timembedded/Carnivore2/Board/3d/CUI_DEVICES_SJ1-3525N.step

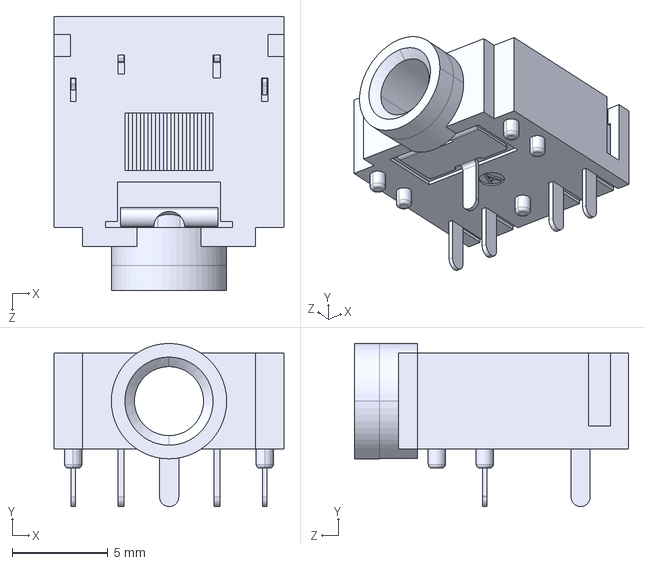
[picture p1: CAD file, 2024-03-19]
Board/3d/CUI_DEVICES_SJ1-3525N.step
12.0 x 8.51 x 14.3 mm
