timembedded/Carnivore2/Board/3d/SG3225CAN.stp

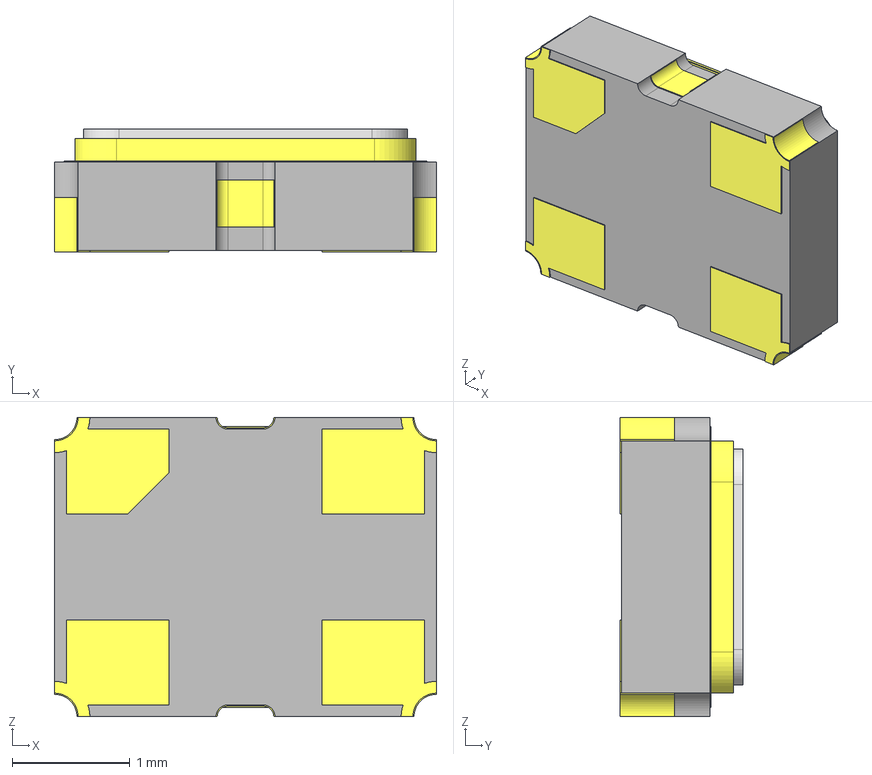
[picture p2: CAD file, 2024-03-19]
Board/3d/SG3225CAN.stp
3.24 x 1.04 x 2.54 mm
SG3225CAN0001
SG3225CAN0002
SG3225CAN0003
SG3225CAN0004
SG3225CAN0005
SG3225CAN0006
SG3225CAN0007
