timembedded/Carnivore2/Board/3d/3505-34-01_step.stp

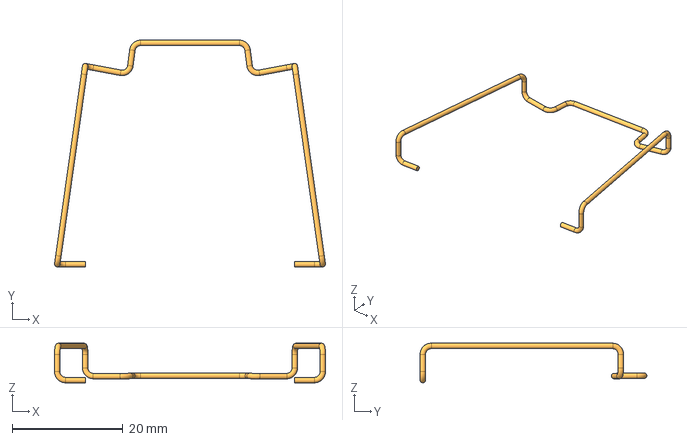
[picture p3: CAD file, 2024-03-19]
Board/3d/3505-34-01_step.stp
49.0 x 41.0 x 7.16 mm
