timembedded/Carnivore2/Board/3d/header_awhw10g-0202-t.stp

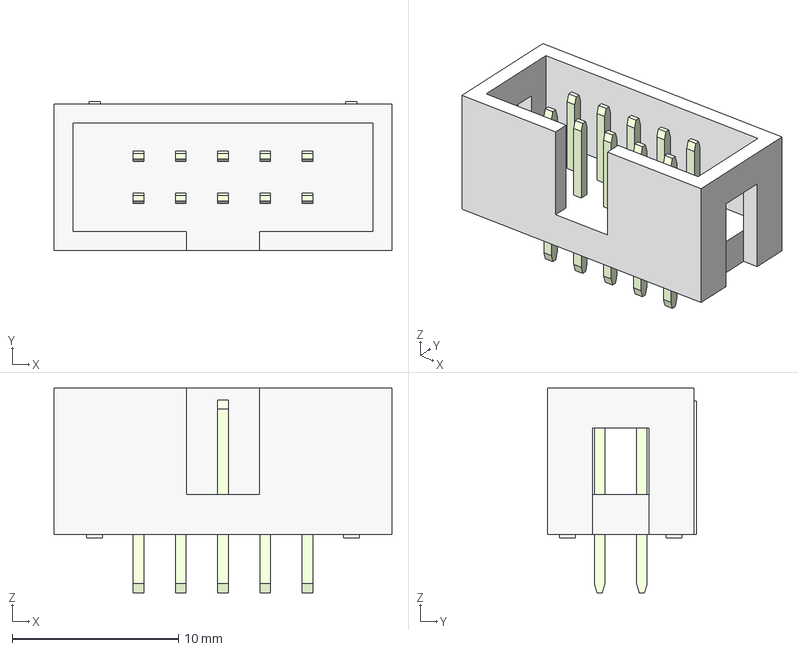
[picture p4: CAD file, 2024-03-19]
Board/3d/header_awhw10g-0202-t.stp
20.3 x 8.95 x 12.3 mm
