timembedded/Carnivore2/Board/3d/N7E50-X516-20-01_step.stp

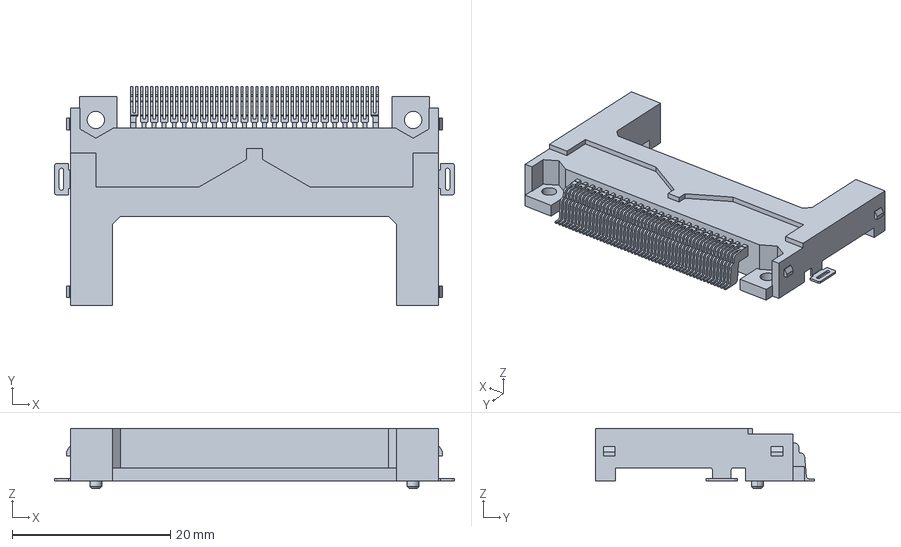
[picture p5: CAD file, 2024-03-19]
Board/3d/N7E50-X516-20-01_step.stp
50.6 x 27.8 x 7.64 mm
