timembedded/Carnivore2/Board/3d/302-S101.step

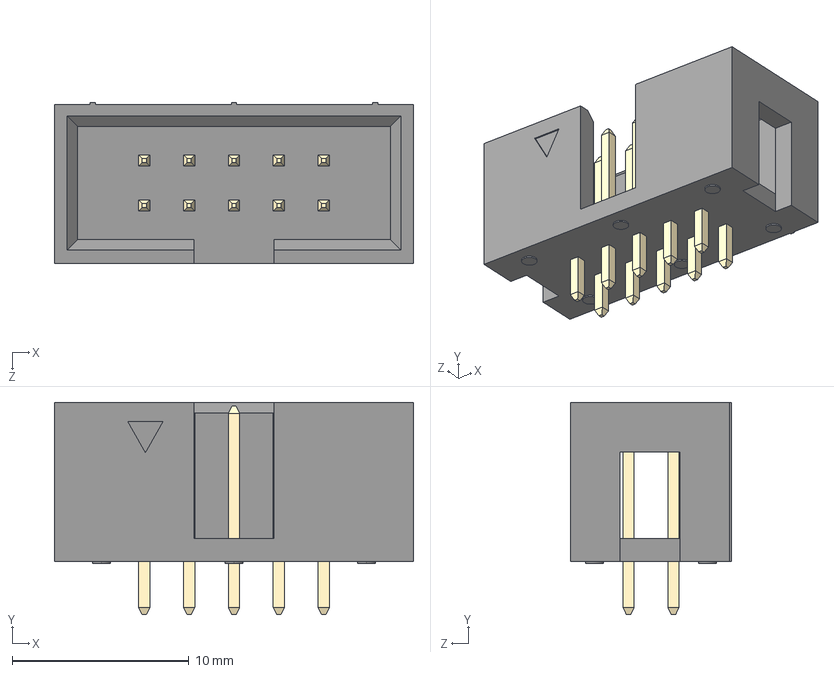
[picture p6: CAD file, 2024-03-19]
Board/3d/302-S101.step
20.3 x 12.0 x 9.10 mm
