timembedded/Carnivore2/Board/3d/612010235221rev1.stp

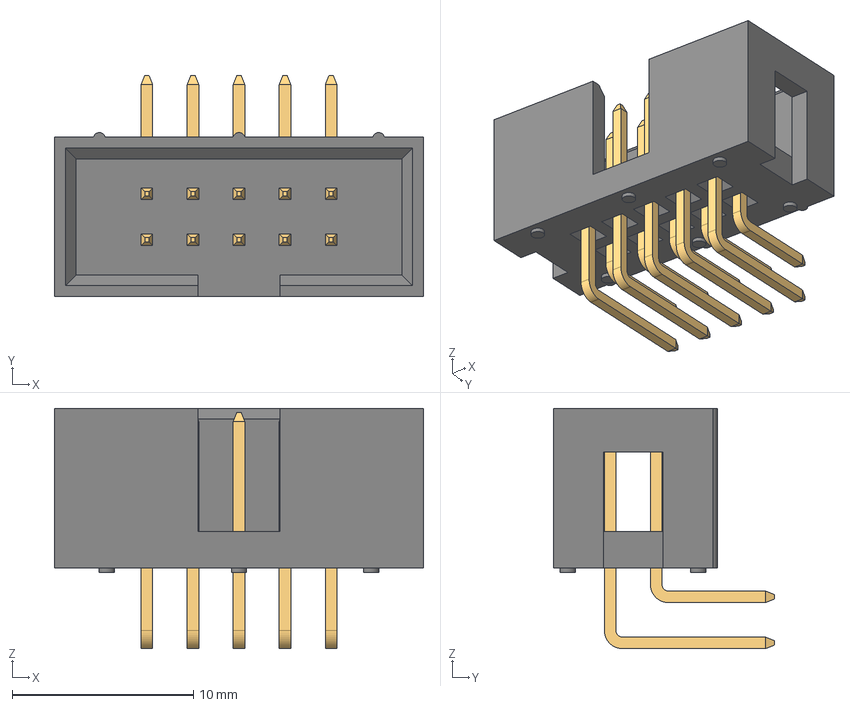
[picture p7: CAD file, 2024-03-19]
Board/3d/612010235221rev1.stp
20.4 x 12.2 x 13.3 mm
6120xx235221_PIN x 5
6120xx235221_PIN_LONGUE x 5
