timembedded/Carnivore2/Board/Carnivore2.kicad_pcb

## KiCad design Board/Carnivore2.kicad_pcb (2025-11-08)

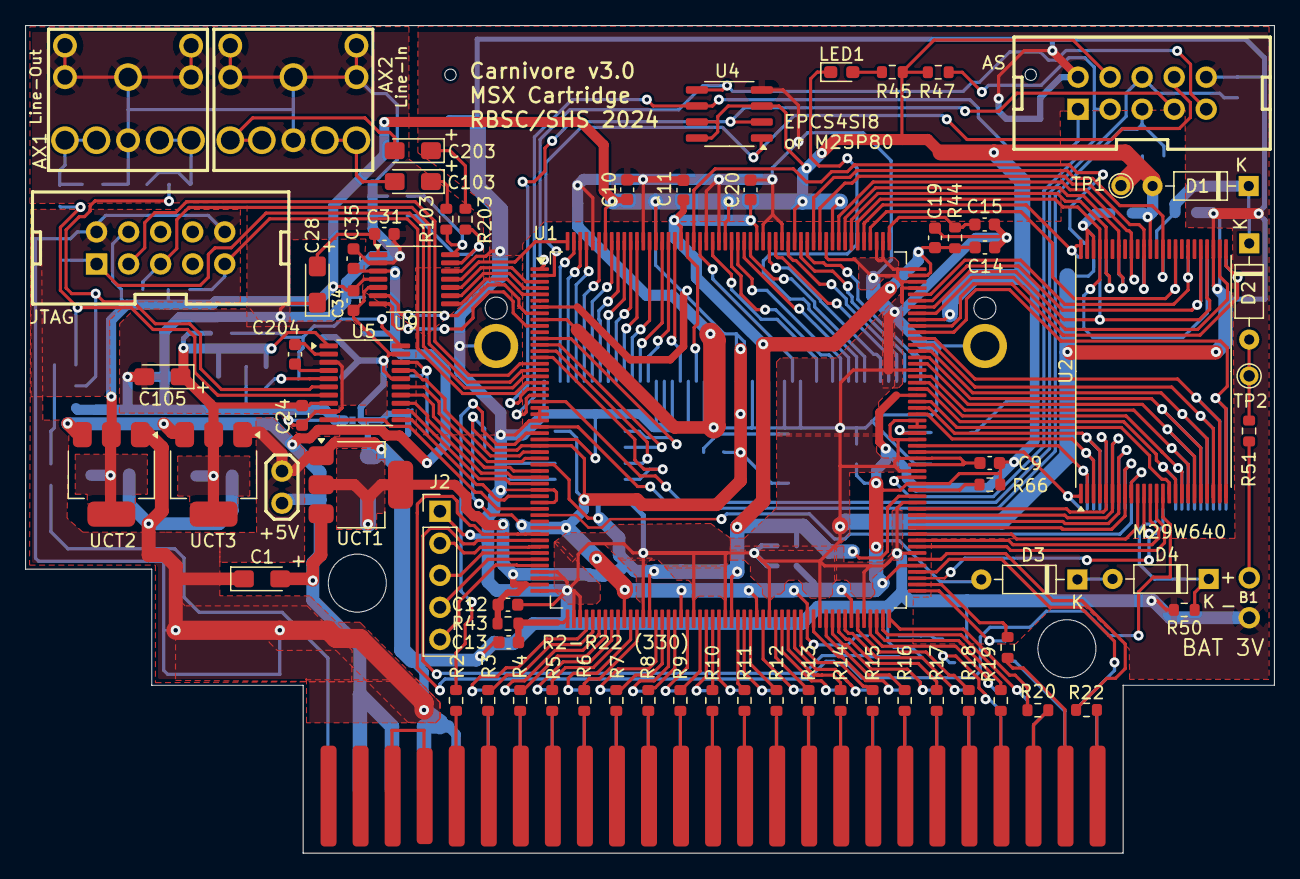
[picture p8: board Carnivore2.kicad_pcb from above]

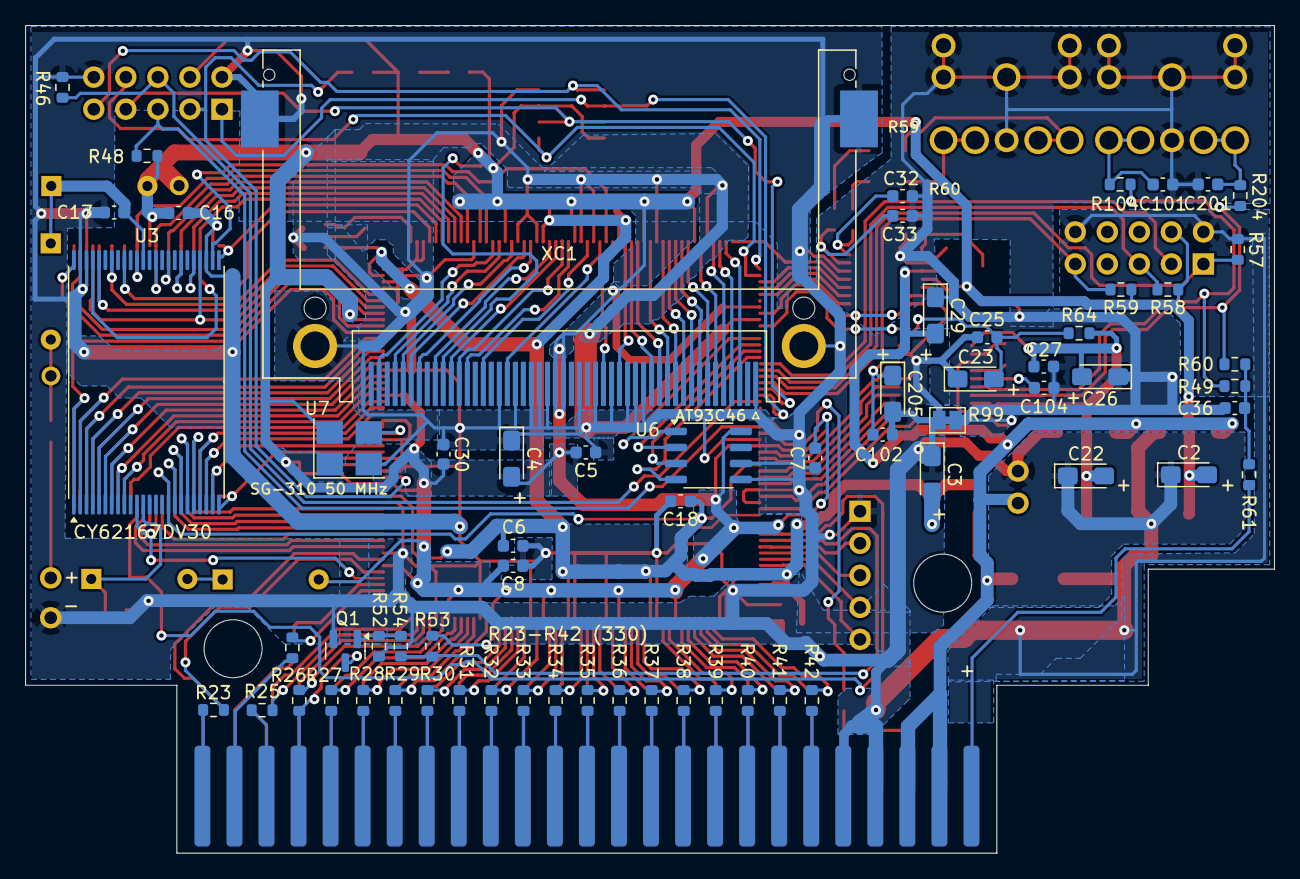
[picture p9: board Carnivore2.kicad_pcb from below]

Board: 2 copper layers, 99.0 x 65.6 mm, 139 parts (65 on the bottom side), 215 nets.

Parts:
AX1, AX2: SJ1-3523N; ST-222_1
B1: BAT 3V; BAT
C1, C2, C3, C4, C22, C23, C26, C28, C29, C105, C205: 10uF 10V; CP_EIA-3216-10_Kemet-I_Pad1.58x1.35mm_HandSolder
C5, C6, C7, C8, C9, C10, C11, C12, C13, C14, C15, C16, C17, C18, C19, C20, C24, C25, C27, C30, C31, C32, C33, C34, C35, C102: 100nF; C_0603_1608Metric
C36, C101, C201: 2.2nF; C_0603_1608Metric
C103, C203: 1uF 10V; CP_EIA-3216-10_Kemet-I_Pad1.58x1.35mm_HandSolder
C104, C204: 2.2uF; C_0603_1608Metric
D1, D2, D3, D4: 1N4148; D_DO-35_SOD27_P7.62mm_Horizontal
H1, H2: MountingHole
J1: Conn_01x02_Pin; JUMPER_1
J2: Conn_01x05_Pin; PinHeader_1x05_P2.54mm_Vertical
LED1: 150060YS75000; LED_0603_1608Metric_Pad1.05x0.95mm_HandSolder
Q1: MMBT3904-TP; SOT-23
R2, R3, R4, R5, R6, R7, R8, R9, R10, R11, R12, R13, R14, R15, R16, R17, R18, R19, R20, R21, R22, R23, R24, R25, R26, R27, R28, R29, R30, R31, R32, R33, R34, R35, R36, R37, R38, R39, R40, R41, R42: 330E; R_0603_1608Metric
R43, R44, R64: 10E; R_0603_1608Metric
R45: 220E; R_0603_1608Metric
R46, R47, R48, R50, R52, R66: 10k; R_0603_1608Metric
R49, R54, R60, R61, R104, R204: 470E; R_0603_1608Metric
R51, R57, R58, R59: 1k; R_0603_1608Metric
R53: 4k7; R_0603_1608Metric
R99: 0E; SolderJumper-2_P1.3mm_Bridged_Pad1.0x1.5mm
R103, R203: 75E; R_0603_1608Metric
TP1, TP2: TestPoint; TestPoint_THTPad_D1.5mm_Drill0.9mm
U1: EP2C8Q208C8N; PQFP-208_28x28mm_P0.5mm
U2: MX29LV640ETTI-70G; TSOP-I-48_18.4x12mm_P0.5mm
U3: RMLV1616AGSA-5S#KA0; TSOP-I-48_18.4x12mm_P0.5mm
U4: M25P80-VMN3TPB; SO-8_3.9x4.9mm_P1.27mm
U5: PCM5101APWR; TSSOP-20_4.4x6.5mm_P0.65mm
U6: AT93C46DN-SH-T; SO-8_3.9x4.9mm_P1.27mm
U7: SG3225CAN 50.0000M-TJGA6; SG3225CAN
U9: PCM1808PWR; TSSOP-14_4.4x5mm_P0.65mm
UCT1: AP2114HA-1.2TRG1; SOT-223
UCT2, UCT3: AP2111H-3.3TRG1; SOT-223
X1: EDGE50/MSX; EDGE50_MSX_1
X2, X3: 302-S101
XC1: 101D-TAAB-R01; CF-Card_101D-TAAB-R01

Connections:
/+1V2: C3.2 (PLUS), C6.2, C11.1, C12.2, C14.1, C18.1, C19.2, C20.1, R43.2, R44.1, U1.32 (VCCINT), U1.51 (VCCD_PLL1), U1.66 (VCCINT), U1.79 (VCCINT), U1.120 (VCCINT), U1.155 (VCCD_PLL2), U1.178 (VCCINT), U1.190 (VCCINT), UCT1.2 (OUT), UCT1.4 (OUT)
/+3.3V: C2.2 (PLUS), C4.2 (PLUS), C5.2, C7.2, C8.2, C9.2, C10.1, C16.2, C30.2, C34.2, D1.2 (A), D3.2 (A), R45.1, R47.2, R48.1, R53.1, R58.1, R59.1, R66.1, TP1.1, U1.7 (VCCIO1), U1.29 (VCCIO1), U1.42 (VCCIO1), U1.62 (VCCIO4), U1.71 (VCCIO4), U1.83 (VCCIO4), U1.91 (VCCIO4), U1.98 (VCCIO4), U1.109 (VCCIO3), U1.122 (VCCIO3), U1.136 (VCCIO3), U1.148 (VCCIO3), U1.166 (VCCIO2), U1.172 (VCCIO2), U1.183 (VCCIO2), U1.194 (VCCIO2), U1.202 (VCCIO2), U2.37 (VCC), U4.3 (~W), U4.7 (~HOLD), U4.8 (V_{CC}), U6.8 (VCC), U7.4 (VCC), U9.4 (VDD), UCT2.2 (OUT), UCT2.4 (OUT), X2.4, X3.4, XC1.13, XC1.38
/+3.3VDAC: C22.2 (PLUS), C24.2, C26.2 (PLUS), C27.2, C105.1 (PLUS), R64.2, U5.1 (CPVDD), U5.8 (AVDD), UCT3.2 (OUT), UCT3.4 (OUT)
/+5V: C1.2 (PLUS), C29.2 (PLUS), C35.2, J1.2, U9.3 (VCC), UCT1.3 (IN), UCT2.3 (IN), UCT3.3 (IN), X1.45, X1.47
/ADC_BCK: U1.5 (IO,_LVDS8p), U9.8 (BCK)
/ADC_DOUT: U1.4 (IO,_LVDS9n_(CLKUSR)), U9.9 (DOUT)
/ADC_LRCK: U1.10 (IO,_LVDS7n,_DQ1L1/_), U9.7 (LRCK)
/ADC_MD0: U1.3 (IO,_LVDS9p_(CRC_ERROR)), U9.10 (MD0)
/ADC_MD1: U1.208 (IO,_LVDS16n), U9.11 (MD1)
/ADC_SCKI: U1.8 (IO,_LVDS7p,_DQ1L0/_), U9.6 (SCKI)
/AGND: AX1.1, AX1.M (Mount), AX2.1, AX2.M (Mount), C24.1, C26.1 (MINUS), C27.1, C28.1 (MINUS), C29.1 (MINUS), C31.1, C32.1, C33.1, C35.1, C36.2, C101.1, C104.2, C105.2 (MINUS), C201.2, R99.2, U5.3 (CPGND), U5.9 (AGND), U9.2 (AGND)
/ASDO: U1.1 (IO,_(ASDO)), U4.5 (DQ0), X2.9
/CLC50: U1.130 (CLK6,_LVDSCLK3p_INPUT), U7.3 (OUT)
/DAC_BCK: U1.34 (IO,_DQ1L5/_), U5.13 (BCK)
/DAC_DEMP: U1.39 (IO,_LVDS3n,_DQ1L7/_), U5.10 (DEMP)
/DAC_DIN: U1.33 (IO,_LVDS6n,_DQ1L4/_), U5.14 (DIN)
/DAC_FLT: U1.37 (IO,_VREFB1N1), U5.11 (FLT)
/DAC_LRCK: U1.31 (IO,_LVDS7n), U5.15 (LRCK)
/DAC_SCK: U1.35 (IO,_LVDS2p,_DQ1L6/_), U5.12 (SCK)
/DAC_XSMT: U1.30 (IO,_LVDS7p,_(DPCLK1/DQS1L)/(DPCLK1/DQS1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), U5.17 (XSMT)
/DATA0: U1.20 (DATA0), U4.2 (DQ1), X2.7
/DCLK: U1.21 (DCLK), U4.6 (C), X2.1
/EECK: U1.13 (IO,_VREFB1N0), U6.2 (SK)
/EECS: U1.12 (IO,_LVDS6n,_DQ1L3/_), U6.1 (CS)
/EEDI: U1.14 (IO,_LVDS8p,_(DPCLK0/DQS0L)/(DPCLK0/DQS0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), U6.3 (DI)
/EEDO: U1.15 (IO,_LVDS8n), U6.4 (DO)
/GND: B1.NEG, C1.1 (MINUS), C2.1 (MINUS), C3.1 (MINUS), C4.1 (MINUS), C5.1, C6.1, C7.1, C8.1, C9.1, C10.2, C11.2, C12.1, C13.1, C14.2, C15.2, C16.1, C17.2, C18.2, C19.1, C20.2, C22.1 (MINUS), C23.1 (MINUS), C25.1, C30.1, C34.1, C102.1, C205.2 (MINUS), J1.1, J2.1, Q1.2 (E), R46.1, R50.2, R52.2, R57.1, R99.1, U1.9 (GND), U1.23 (CLK0,_LVDSCLK0p_INPUT), U1.24 (CLK1,_LVDSCLK0n_INPUT), U1.25 (GND), U1.28 (CLK3,_LVDSCLK1n_INPUT), U1.36 (GND), U1.38 (GND), U1.49 (GND), U1.50 (GND_PLL1), U1.52 (GND_PLL1), U1.54 (GNDA_PLL1), U1.55 (GND), U1.65 (GND), U1.73 (GND), U1.78 (GND), U1.85 (GND), U1.93 (GND), U1.100 (GND), U1.111 (GND), U1.119 (GND), U1.124 (GND), U1.125 (MSEL1), U1.126 (MSEL0), U1.129 (CLK7,_LVDSCLK3n_INPUT), U1.131 (CLK5,_LVDSCLK2n_INPUT), U1.132 (CLK4,_LVDSCLK2p_INPUT), U1.140 (GND), U1.153 (GND), U1.154 (GND_PLL2), U1.156 (GND_PLL2), U1.158 (GNDA_PLL2), U1.159 (GND), U1.167 (GND), U1.174 (GND), U1.177 (GND), U1.184 (GND), U1.186 (GND), U1.196 (GND), U1.204 (GND), U2.27 (GND), U2.46 (GND), U2.47 (~BYTE), U3.27 (GND), U3.46 (GND), U3.47 (~BYTE), U4.4 (V_{SS}), U5.16 (FMT), U5.19 (DGND), U6.5 (GND), U6.6 (ORG), U7.2 (GND), U9.5 (DGND), U9.12 (FMT), UCT1.1 (GND), UCT2.1 (GND), UCT3.1 (GND), X1.41, X1.43, X2.2, X2.10, X3.2, X3.10, XC1.1, XC1.8, XC1.9, XC1.10, XC1.11, XC1.12, XC1.14, XC1.15, XC1.16, XC1.17, XC1.33, XC1.39, XC1.50, XC1.51 (MH1), XC1.52 (MH2), XC1.53 (MH3), XC1.54 (MH4)
/HA0: U1.180 (IO,_LVDS29p), XC1.20
/HA1: U1.182 (IO,_LVDS28p), XC1.19
/HA2: U1.185 (IO,_LVDS26p,_DQ1T0/DQ1T9), XC1.18
/HD00: U1.179 (IO,_LVDS29n,_DM0T/(DM1T0/BWS#1T0)), XC1.21
/HD01: U1.176 (IO,_LVDS31p,__/DQ1T8), XC1.22
/HD02: U1.173 (IO,_LVDS33p,_DQ0T6/DQ1T6), XC1.23
/HD03: U1.207 (IO,_LVDS16p,_(DM1T/BWS#1T)/(DM1T1/BWS#1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), XC1.2
/HD04: U1.205 (IO,_LVDS17p,_DQ1T8/DQ1T17), XC1.3
/HD05: U1.201 (IO,_LVDS18n,_DQ1T6/DQ1T15), XC1.4
/HD06: U1.199 (IO,_LVDS19n), XC1.5
/HD07: U1.197 (IO,_LVDS21n), XC1.6
/HD08: U1.175 (IO,_LVDS31n,_DQ0T7/DQ1T7), XC1.47
/HD09: U1.171 (IO,_LVDS33n,_DQ0T5/DQ1T5), XC1.48
/HD10: U1.170 (IO,_VREFB2N0), XC1.49
/HD11: U1.206 (IO,_LVDS17n_(DEV_CLRn)), XC1.27
/HD12: U1.203 (IO,_LVDS18p,_DQ1T7/DQ1T16), XC1.28
/HD13: U1.200 (IO,_LVDS19p,_(DPCLK10/DQS1T)/(DPCLK10/D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), XC1.29
/HD14: U1.198 (IO,_LVDS21p), XC1.30
/HD15: U1.195 (IO,_LVDS23p,_DQ1T5/DQ1T14), XC1.31
/NCE: R46.2, U1.22 (nCE), X2.6
/NCONFIG: R48.2, U1.26 (nCONFIG), X2.5
/NCSO: U1.2 (IO,_(nCSO)), U4.1 (~S), X2.8
/RA00: U1.147 (IO,_LVDS39p,_DQ0R0/DQ1R0), U2.25 (A0), U3.48 (A16)
/RA01: U1.146 (IO,_LVDS39n,_DQ0R1/DQ1R1), U2.24 (A1), U3.1 (A15)
/RA02: U1.145 (IO,_VREFB3N0), U2.23 (A2), U3.2 (A14)
/RA03: U1.144 (IO,_LVDS42p,_DQ0R2/DQ1R2), U2.22 (A3), U3.3 (A13)
/RA04: U1.143 (IO,_LVDS42n,_DQ0R3/DQ1R3), U2.21 (A4), U3.4 (A12)
/RA05: U1.142 (IO,_LVDS44p,_DQ0R4/DQ1R4), U2.20 (A5), U3.5 (A11)
/RA06: U1.141 (IO,_LVDS44n,_DQ0R5/DQ1R5), U2.19 (A6), U3.6 (A10)
/RA07: U1.139 (IO,_LVDS45p,_DQ0R6/DQ1R6), U2.18 (A7), U3.7 (A9)
/RA08: U1.115 (IO,_LVDS51n,_DQ1R4/DQ1R13), U2.8 (A8), U3.17 (A17)
/RA09: U1.116 (IO,_LVDS51p,_DQ1R3/DQ1R12), U2.7 (A9), U3.18 (A7)
/RA10: U1.117 (IO,_VREFB3N1), U2.6 (A10), U3.19 (A6)
/RA11: U1.118 (IO,_DQ1R2/DQ1R11), U2.5 (A11), U3.20 (A5)
/RA12: U1.134 (IO,_LVDS47p,_(DPCLK7/DQS0R)/(DPCLK7/DQS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), U2.4 (A12), U3.21 (A4)
/RA13: U1.133 (IO,_LVDS47n,_DQ1R0/DQ1R9), U2.3 (A13), U3.22 (A3)
/RA14: U1.128 (IO,_LVDS48p,_(DPCLK6/DQS1R)/(DPCLK6/DQS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), U2.2 (A14), U3.23 (A2)
/RA15: U1.127 (IO,_LVDS48n,_DQ1R1/DQ1R10), U2.1 (A15), U3.24 (A1)
/RA16: U1.161 (IO,_LVDS37p,_DQ0T0/DQ1T0), U2.48 (A16), U3.25 (A0)
/RA17: U1.138 (IO,_LVDS45n,_DQ0R7/DQ1R7), U2.17 (A17), U3.8 (A8)
/RA18: U1.137 (IO,_LVDS46p,__/DQ1R8), U2.16 (A18), U3.9 (A19)
/RA19: U1.40 (IO,_LVDS2p,_DQ1L8/_), U2.9 (A19), U3.16 (A18)
/RA20: U1.114 (IO,_LVDS52p,_DQ1R5/DQ1R14), U2.10 (A20)
/RA21: U1.112 (IO,_LVDS53p,_DQ1R7/DQ1R16), U2.13 (A21)
/RDQ0: U1.151 (IO,_PLL2_OUTp), U2.29 (D0), U3.44 (D7)
/RDQ1: U1.152 (IO,_PLL2_OUTn), U2.31 (D1), U3.42 (D6)
/RDQ2: U1.160 (IO,_LVDS37n), U2.33 (D2), U3.40 (D5)
/RDQ3: U1.169 (IO,_LVDS34p,_(DPCLK8/DQS0T)/(DPCLK8/DQS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), U2.35 (D3), U3.38 (D4)
/RDQ4: U1.168 (IO,_LVDS34n), U2.38 (D4), U3.35 (D3)
/RDQ5: U1.165 (IO,_LVDS35p,_DQ0T4/DQ1T4), U2.40 (D5), U3.33 (D2)
/RDQ6: U1.164 (IO,_LVDS35n,_DQ0T3/DQ1T3), U2.42 (D6), U3.31 (D1)
/RDQ7: U1.163 (IO,_LVDS36p,_DQ0T2/DQ1T2), U2.44 (D7), U3.29 (D0)
/RDQ15A-1: U1.162 (IO,_LVDS36n,_DQ0T1/DQ1T1), U2.45 (D15), U3.45 (D15)
/RSW1: R15.2, U1.90 (IO,_LVDS61p,_DQ0B5/DQ1B5)
/RSW2: R25.1, U1.103 (IO,_LVDS57p)
/RVPPE: U1.43 (IO), U2.14 (Vpp/~WP)
/R~E: U1.149 (IO,_LVDS38n), U2.26 (~CE)
/R~G: U1.150 (IO,_LVDS38p), U2.28 (~OE), U3.28 (~OE)
/SLTSOUND: R61.2, X1.49
/SLT_A00: R9.2, U1.74 (IO,_LVDS68p,_DQ1B0/DQ1B9)
/SLT_A01: R36.1, U1.72 (IO,_LVDS68n,_DQ1B1/DQ1B10)
/SLT_A02: R8.2, U1.70 (IO,_LVDS68p,_DQ1B2/DQ1B11)
/SLT_A03: R37.1, U1.69 (IO,_LVDS70n,_DQ1B3/DQ1B12)
/SLT_A04: R7.2, U1.68 (IO,_LVDS70p,_DQ1B4/DQ1B13)
/SLT_A05: R38.1, U1.67 (IO,_VREFB4N1)
/SLT_A06: R12.2, U1.82 (IO,_LVDS64n)
/SLT_A07: R33.1, U1.81 (IO,_LVDS64p)
/SLT_A08: R11.2, U1.80 (IO)
/SLT_A09: R31.1, U1.87 (IO,_LVDS62p,_DQ0B7/DQ1B7)
/SLT_A10: R13.2, U1.86 (IO,_LVDS63n,__/DQ1B8)
/SLT_A11: R32.1, U1.84 (IO,_LVDS63p,_DM0B/(DM1B0/BWS#1B0))
/SLT_A12: R34.1, U1.77 (IO,_LVDS66n)
/SLT_A13: R10.2, U1.76 (IO,_LVDS66p)
/SLT_A14: R35.1, U1.75 (IO,_LVDS68n)
/SLT_A15: R14.2, U1.88 (IO,_LVDS62n,_DQ0B6/DQ1B6)
/SLT_CLC: R2.2, U1.27 (CLK2,_LVDSCLK1p_INPUT)
/SLT_D0: R6.2, U1.64 (IO,_LVDS74n)
/SLT_D1: R39.1, U1.63 (IO,_LVDS74p,_(DPCLK2/DQS1B)/(DPCLK2/DQS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)
/SLT_D2: R5.2, U1.61 (IO,_LVDS75n,_DQ1B5/DQ1B14)
/SLT_D3: R40.1, U1.60 (IO,_LVDS75p,_DQ1B6/DQ1B15)
/SLT_D4: R4.2, U1.59 (IO,_LVDS76n,_DQ1B7/DQ1B16)
/SLT_D5: R41.1, U1.58 (IO,_LVDS76p,_DQ1B8/DQ1B17)
/SLT_D6: R3.2, U1.57 (IO,_LVDS77p,_(DM1B/BWS#1B)/(DM1B1/BWS#1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)
/SLT_D7: R42.1, U1.56 (IO,_LVDS77n_(DEV_OE))
/TCK: R57.2, U1.18 (TCK), X3.1
/TDI: R59.2, U1.19 (TDI), X3.9
/TDO: U1.16 (TDO), X3.3
/TMS: R58.2, U1.17 (TMS), X3.5
/~CSRAM: U1.188 (IO,_LVDS25p,_DQ1T1/DQ1T10), U3.26 (~CE1)
/~HCS1: U1.193 (IO,_LVDS23n,_DQ1T4/DQ1T13), XC1.7
/~HCS3: U1.192 (IO,_VREFB2N1), XC1.32
/~HRD: U1.191 (IO,_LVDS24p,_DQ1T3/DQ1T12), XC1.34
/~HREG: U1.181 (IO,_LVDS28n), XC1.44
/~HRST: U1.187 (IO,_LVDS25n), XC1.41
/~HWR: U1.189 (IO,_LVDS24n,_DQ1T2/DQ1T11), XC1.35
/~RRB: U1.135 (IO,_LVDS46n,_DM0R/(DM1R0/BWS#1R0)), U2.15 (R~B)
/~RRP: U1.113 (IO,_LVDS52n,_DQ1R6/DQ1R15), U2.12 (~RP)
/~RWR: U1.107 (IO,_LVDS54n_(INIT_DONE)), U2.11 (~WE), U3.11 (~WE)
/~SLT_BUSDIR: R18.2, U1.99 (IO,_LVDS59n,_DQ0B1/DQ1B1)
/~SLT_CS1: R23.1, U1.108 (IO,_LVDS54p_(nCEO))
/~SLT_CS2: R22.2, U1.110 (IO,_LVDS53n,_DQ1R8/DQ1R17)
/~SLT_CS12: R24.1, U1.105 (IO,_LVDS56n)
/~SLT_INT: R19.2, U1.102 (IO,_LVDS58n)
/~SLT_IORQ: R28.1, U1.95 (IO,_LVDS60n)
/~SLT_M1: R27.1, U1.97 (IO,_LVDS59p,_DQ0B2/DQ1B2)
/~SLT_MREQ: R17.2, U1.96 (IO,_DQ0B3/DQ1B3)
/~SLT_RD: R16.2, U1.94 (IO,_LVDS60p,_(DPCLK4/DQS0B)/(DPCLK4/DQS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)
/~SLT_READY: R53.2, R54.1, U1.44 (IO,_LVDS0p)
/~SLT_RESET: R30.1, U1.89 (IO,_VREFB4N0)
/~SLT_RFSH: R20.2, U1.104 (IO,_LVDS57n)
/~SLT_SLTSEL: R21.2, U1.106 (IO,_LVDS56p,_(DM1R/BWS#1R)/(DM1R1/BWS#1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)
/~SLT_WAIT: R26.1, U1.101 (IO,_LVDS58p,_DQ0B0/DQ1B0)
/~SLT_WR: R29.1, U1.92 (IO,_LVDS61n,_DQ0B4/DQ1B4)
/~X_SLT_WAIT: Q1.3 (C), R26.2, X1.7
unnamed: AX1.2, AX1.3, C201.1, R204.2
unnamed: AX1.4, AX1.5, C101.2, R104.2
unnamed: B1.POS, R51.2
unnamed: C23.2 (PLUS), C25.2, R64.1, U5.20 (DVDD)
unnamed: C28.2 (PLUS), C31.2, U9.1 (VREF)
unnamed: C36.1, R49.2, R60.2, R61.1
unnamed: AX2.4, AX2.5, C103.2 (MINUS)
unnamed: C103.1 (PLUS), R103.2
unnamed: AX2.2, AX2.3, C203.2 (MINUS)
unnamed: C203.1 (PLUS), R203.2
unnamed: C102.2, C205.1 (PLUS), U5.18 (LDOO)
unnamed: C17.1, D1.1 (K), D2.1 (K), U3.37 (VCC)
unnamed: D2.2 (A), R51.1, TP2.1
unnamed: D3.1 (K), D4.2 (A)
unnamed: D4.1 (K), R50.1, U3.12 (CE2)
unnamed: J2.2, U1.45 (IO,_LVDS0n)
unnamed: J2.3, U1.46 (IO)
unnamed: J2.4, U1.47 (IO,_PLL1_OUTp)
unnamed: J2.5, U1.48 (IO,_PLL1_OUTn)
unnamed: LED1.2 (A), R45.2
unnamed: LED1.1 (K), XC1.45
unnamed: Q1.1 (B), R52.1, R54.2
unnamed: R2.1, X1.42
unnamed: R3.1, X1.40
unnamed: R4.1, X1.38
unnamed: R5.1, X1.36
unnamed: R6.1, X1.34
unnamed: R7.1, X1.32
unnamed: R8.1, X1.30
unnamed: R9.1, X1.28
unnamed: R10.1, X1.26
unnamed: R11.1, X1.24
unnamed: R12.1, X1.22
unnamed: R13.1, X1.20
unnamed: R14.1, X1.18
unnamed: R15.1, X1.16
unnamed: R16.1, X1.14
unnamed: R17.1, X1.12
unnamed: R18.1, X1.10
unnamed: R19.1, X1.8
unnamed: R20.1, X1.6
unnamed: R21.1, X1.4
unnamed: R22.1, X1.2
unnamed: R23.2, X1.1
unnamed: R24.2, X1.3
unnamed: R25.2, X1.5
unnamed: R27.2, X1.9
unnamed: R28.2, X1.11
unnamed: R29.2, X1.13
unnamed: R30.2, X1.15
unnamed: R31.2, X1.17
unnamed: R32.2, X1.19
unnamed: R33.2, X1.21
unnamed: R34.2, X1.23
unnamed: R35.2, X1.25
unnamed: R36.2, X1.27
unnamed: R37.2, X1.29
unnamed: R38.2, X1.31
unnamed: R39.2, X1.33
unnamed: R40.2, X1.35
unnamed: R41.2, X1.37
unnamed: R42.2, X1.39
unnamed: R47.1, U1.123 (CONF_DONE), X2.3
unnamed: R66.2, U1.121 (nSTATUS)
unnamed: C13.2, R43.1, U1.53 (VCCA_PLL1)
unnamed: C15.1, R44.2, U1.157 (VCCA_PLL2)
unnamed: C204.2, U5.4 (CAPM)
unnamed: C204.1, U5.2 (CAPP)
unnamed: R49.1, R104.1, U5.6 (OUTL)
unnamed: R60.1, R204.1, U5.7 (OUTR)
unnamed: C104.1, U5.5 (VNEG)
unnamed: C33.2, R203.1, U9.13 (VinL)
unnamed: C32.2, R103.1, U9.14 (VinR)
unnamed: X1.44, X1.46
