timembedded/Carnivore2/(commit log)

2024-02-20 Converted schematic and pcb to KiCad
    [Carnivore2.kicad_pcb, Carnivore2.kicad_sch]
2024-02-23 Schematic and pcb conversion cleanup and rework
    [Carnivore2.kicad_pcb, Carnivore2.kicad_sch]
2024-02-25 Fixed lots of design rule check errors and warnings in pcb Including some serious errors: Lots of fpga GND pins unconnected, C28 connected to wrong net
    [Carnivore2.kicad_pcb, Carnivore2.kicad_sch]
2024-02-26 Created local footprint library
    [Carnivore2.kicad_pcb, Carnivore2.kicad_sch]
2024-02-26 Changed fpga from EP2C5 to EP2C8
    [Carnivore2.kicad_pcb, Carnivore2.kicad_sch]
2024-03-11 Changed audio DAC to modern type, added audio input, updated footprints
    [Carnivore2.kicad_pcb, Carnivore2.kicad_sch]
2024-03-19 Updated more footprints 3D view complete
    [302-S101.step, 3505-34-01_step.stp, 612010235221rev1.stp, CUI_DEVICES_SJ1-3525N.step, Carnivore2.kicad_pcb, Carnivore2.kicad_sch, N7E50-X516-20-01_step.stp, SG3225CAN.stp]
2024-03-25 Some last details
    [Carnivore2.kicad_pcb, Carnivore2.kicad_sch]
2024-03-29 Last update before ordering PCB
    [Carnivore2.kicad_pcb]
2024-04-03 Corrections in silkscreen for wrong direction of some capacitors and all diodes
    [Carnivore2.kicad_pcb, Carnivore2.kicad_sch]
2024-04-26 Test firmware currently only for testing the audio dac
2024-10-19 Added work-in progress redesigned firmware
    [Opll.vhd, PhaseGenerator.vhd, VoiceRom.vhd, address_decoding.vhd, card_slave.vhd, flash_layout.vhd, ide.vhd]
2024-11-14 Set mapper defaults to defaults in boot menu and reversed F5 key meaning Now press F5 to enter menu, by default no menu
    [mega_ram.vhd]
2024-11-17 Updated documentation and modified c2ramldr to directly reboot into the game
    [c2ramldr.asm]
2024-11-20 Simplified registers, implemented not-expanded setting and fixed bug in soft reset detect
    [address_decoding.vhd, card_slave.vhd, mega_ram.vhd, top.vhd]
2025-02-27 Hardware modification to delay Z80 startup until FPGA is configured Needed on FS-A1W(S)X models
    [Carnivore2.kicad_pcb, Carnivore2.kicad_sch]
2025-10-16 Minor improvements
    [Carnivore2.kicad_pcb, Carnivore2.kicad_sch]
2025-11-08 Improved slot wait
    [Carnivore2.kicad_pcb, Carnivore2.kicad_sch]
