timembedded/Carnivore2/(notices)

Notices in the files:
Board/carnivore2.sch:
(copyright "Copyright © 1992-2006 Altium Limited")
